Touka-Juini/real-time-traffic-monitoring-system/media/prototype/proto2.png

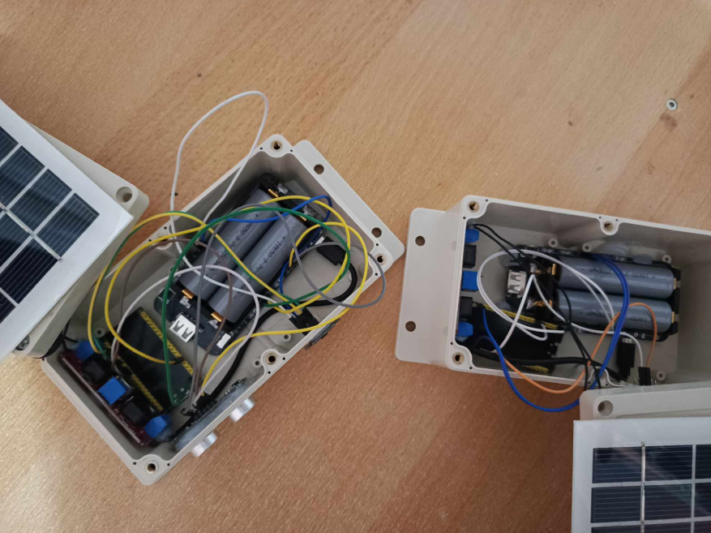
media/prototype/proto2.png
