Touka-Juini/real-time-traffic-monitoring-system/media/prototype/dashboard.png

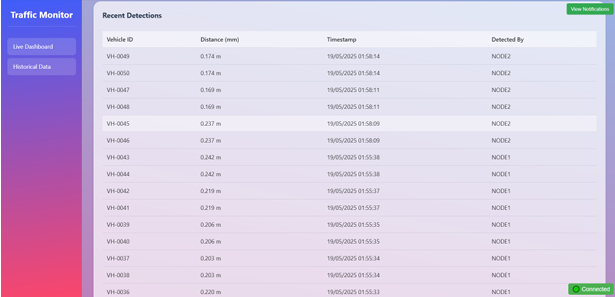
media/prototype/dashboard.png
