Touka-Juini/real-time-traffic-monitoring-system/media/prototype/proto1.png

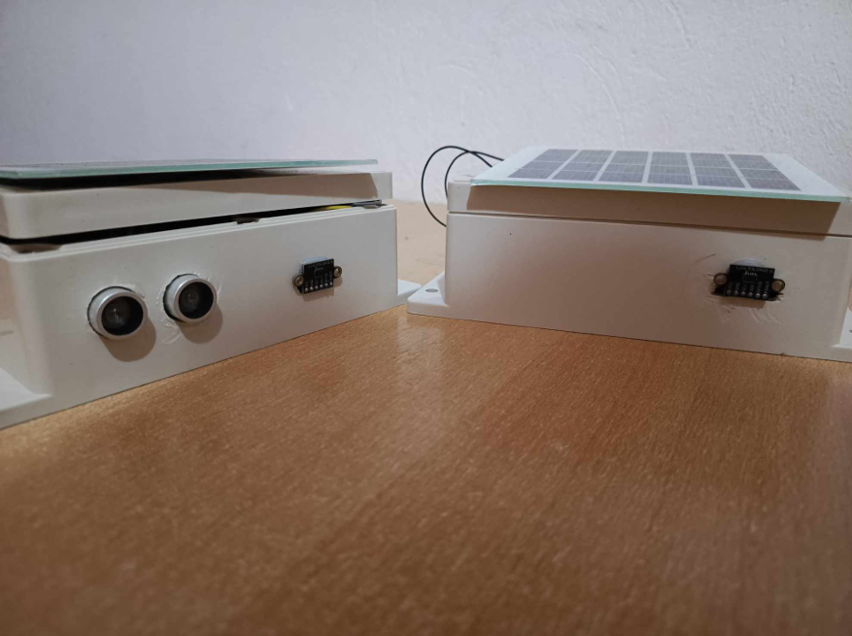
media/prototype/proto1.png
