Touka-Juini/real-time-traffic-monitoring-system/(commit log)

2026-10-19 Add ESP32 traffic node firmware with sensors
2026-10-19 Add vehicle detection system with MQTT support
    This code implements a vehicle detection system using a VL53L0X sensor, WiFi, and MQTT for communication. It connects to a specified WiFi network, initializes the sensor, and continuously reads distances to detect vehicles, publishing the count and distance via MQTT.
2026-10-19 Add VL53L0X sensor integration with MQTT
2026-10-19 Add HCRS04 ultrasonic sensor test sketch
2026-10-19 Add HB100 sensor pulse counting example
2026-10-19 Implement SocketIO event emission functions
2026-10-19 Implement SocketIO event emission functions
    Added functions to emit vehicle data, counts, and chart data via SocketIO.
2026-10-19 Fix prototype demo link in README.md
